bazsimarkus/Simple-8085-Arduino-System/Schematic/Schematic.pdf

# 470R GND GND GND

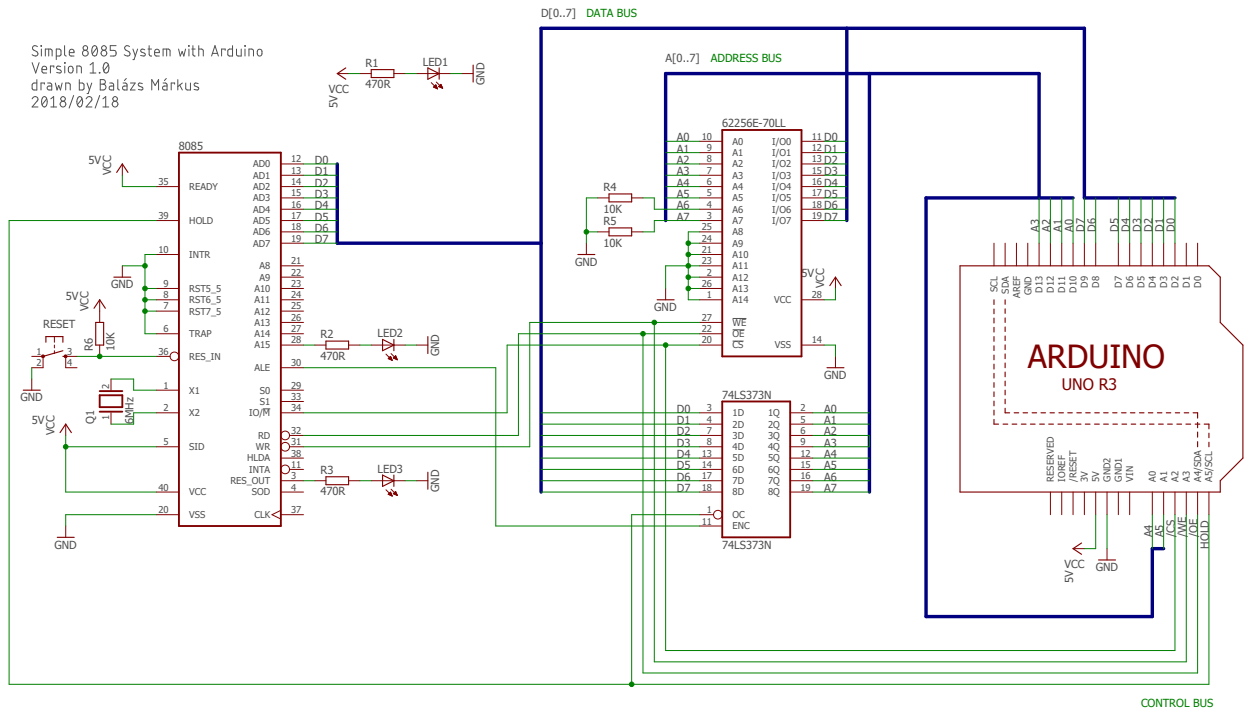
[picture p4: page 1]

A[0..7] ADDRESS BUS

D2 7 | 6
D3 8 | 9

D6 | A6
D7
