bazsimarkus/Simple-8085-Arduino-System/Schematic/Schematic.sch

## EAGLE design Schematic/Schematic.sch (2020-03-29)

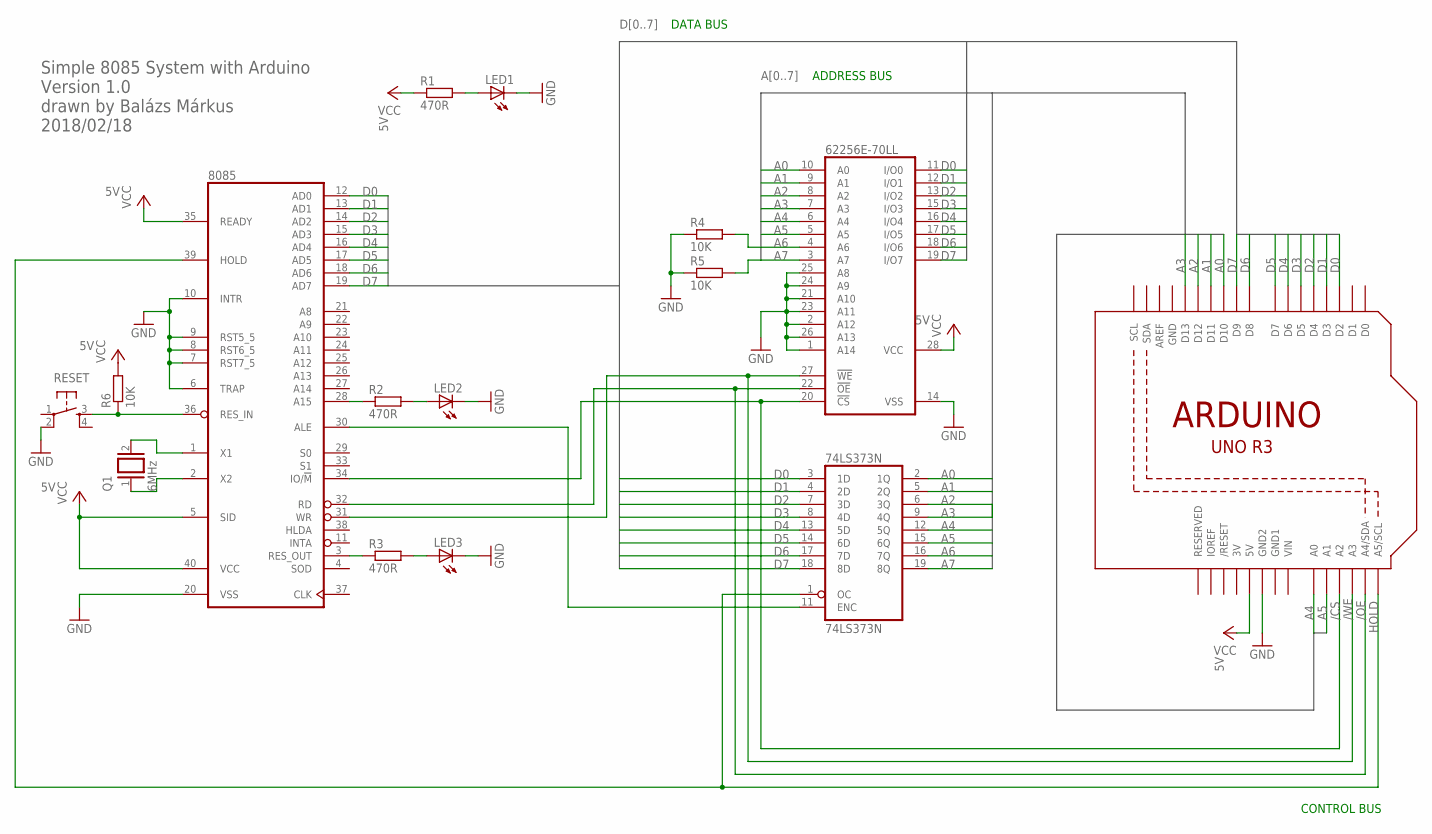
[picture p5: schematic Schematic.sch]

Parts:
74LS373N: 74LS373N; DIL20
8085: 8085; DIL40
62256E-70LL: 62256P; DIL28-6
ARDUINO: ARDUINOR3-BPLACE
LED1, LED2, LED3: LED5MM
Q1: 6MHz; Q
R1, R2, R3: 470R; 0207/5V
R4, R5, R6: 10K; 0207/5V
RESET: TAC_SWITCHPTH; TACTILE-PTH

Connections:
/CS: 8085.34 (IO/!M), 62256E-70LL.20 (!CS), ARDUINO.A2
/OE: 8085.32 (RD), 62256E-70LL.22 (!OE), ARDUINO.A4 (A4/SDA)
/WE: 8085.31 (WR), 62256E-70LL.27 (!WE), ARDUINO.A3
A0: 74LS373N.2 (1Q), 62256E-70LL.10 (A0), ARDUINO.D10
A1: 74LS373N.5 (2Q), 62256E-70LL.9 (A1), ARDUINO.D11
A2: 74LS373N.6 (3Q), 62256E-70LL.8 (A2), ARDUINO.D12
A3: 74LS373N.9 (4Q), 62256E-70LL.7 (A3), ARDUINO.D13
A4: 74LS373N.12 (5Q), 62256E-70LL.6 (A4), ARDUINO.A0
A5: 74LS373N.15 (6Q), 62256E-70LL.5 (A5), ARDUINO.A1
A6: 74LS373N.16 (7Q), 62256E-70LL.4 (A6), R4.2
A7: 74LS373N.19 (8Q), 62256E-70LL.3 (A7), R5.2
D0: 74LS373N.3 (1D), 8085.12 (AD0), 62256E-70LL.11 (I/O0), ARDUINO.D2
D1: 74LS373N.4 (2D), 8085.13 (AD1), 62256E-70LL.12 (I/O1), ARDUINO.D3
D2: 74LS373N.7 (3D), 8085.14 (AD2), 62256E-70LL.13 (I/O2), ARDUINO.D4
D3: 74LS373N.8 (4D), 8085.15 (AD3), 62256E-70LL.15 (I/O3), ARDUINO.D5
D4: 74LS373N.13 (5D), 8085.16 (AD4), 62256E-70LL.16 (I/O4), ARDUINO.D6
D5: 74LS373N.14 (6D), 8085.17 (AD5), 62256E-70LL.17 (I/O5), ARDUINO.D7
D6: 74LS373N.17 (7D), 8085.18 (AD6), 62256E-70LL.18 (I/O6), ARDUINO.D8
D7: 74LS373N.18 (8D), 8085.19 (AD7), 62256E-70LL.19 (I/O7), ARDUINO.D9
GND: 8085.6 (TRAP), 8085.7 (RST7_5), 8085.8 (RST6_5), 8085.9 (RST5_5), 8085.10 (INTR), 8085.20 (VSS), 62256E-70LL.1 (A14), 62256E-70LL.2 (A12), 62256E-70LL.14 (VSS), 62256E-70LL.21 (A10), 62256E-70LL.23 (A11), 62256E-70LL.24 (A9), 62256E-70LL.25 (A8), 62256E-70LL.26 (A13), ARDUINO.GND2, LED1.K (C), LED2.K (C), LED3.K (C), R4.1, R5.1, RESET.2
HOLD: 74LS373N.1 (OC), 8085.39 (HOLD), ARDUINO.A5 (A5/SCL)
unnamed: 8085.1 (X1), Q1.2
unnamed: 8085.2 (X2), Q1.1
unnamed: 8085.36 (RES_IN), R6.1, RESET.3
unnamed: 74LS373N.11 (ENC), 8085.30 (ALE)
unnamed: 8085.28 (A15), R2.1
unnamed: LED2.A, R2.2
unnamed: 8085.3 (RES_OUT), R3.1
unnamed: LED3.A, R3.2
unnamed: LED1.A, R1.2
VCC: 8085.5 (SID), 8085.35 (READY), 8085.40 (VCC), 62256E-70LL.28 (VCC), ARDUINO.5V, R1.1, R6.2

Notes on the sheet:
DATA BUS
ADDRESS BUS
CONTROL BUS
Simple 8085 System with Arduino Version 1.0 drawn by Balázs Márkus 2018/02/18
